UCI-HyperXite/HX8_InverterBoard/Inverter V3.brd

## EAGLE design Inverter V3.brd (2023-04-27)

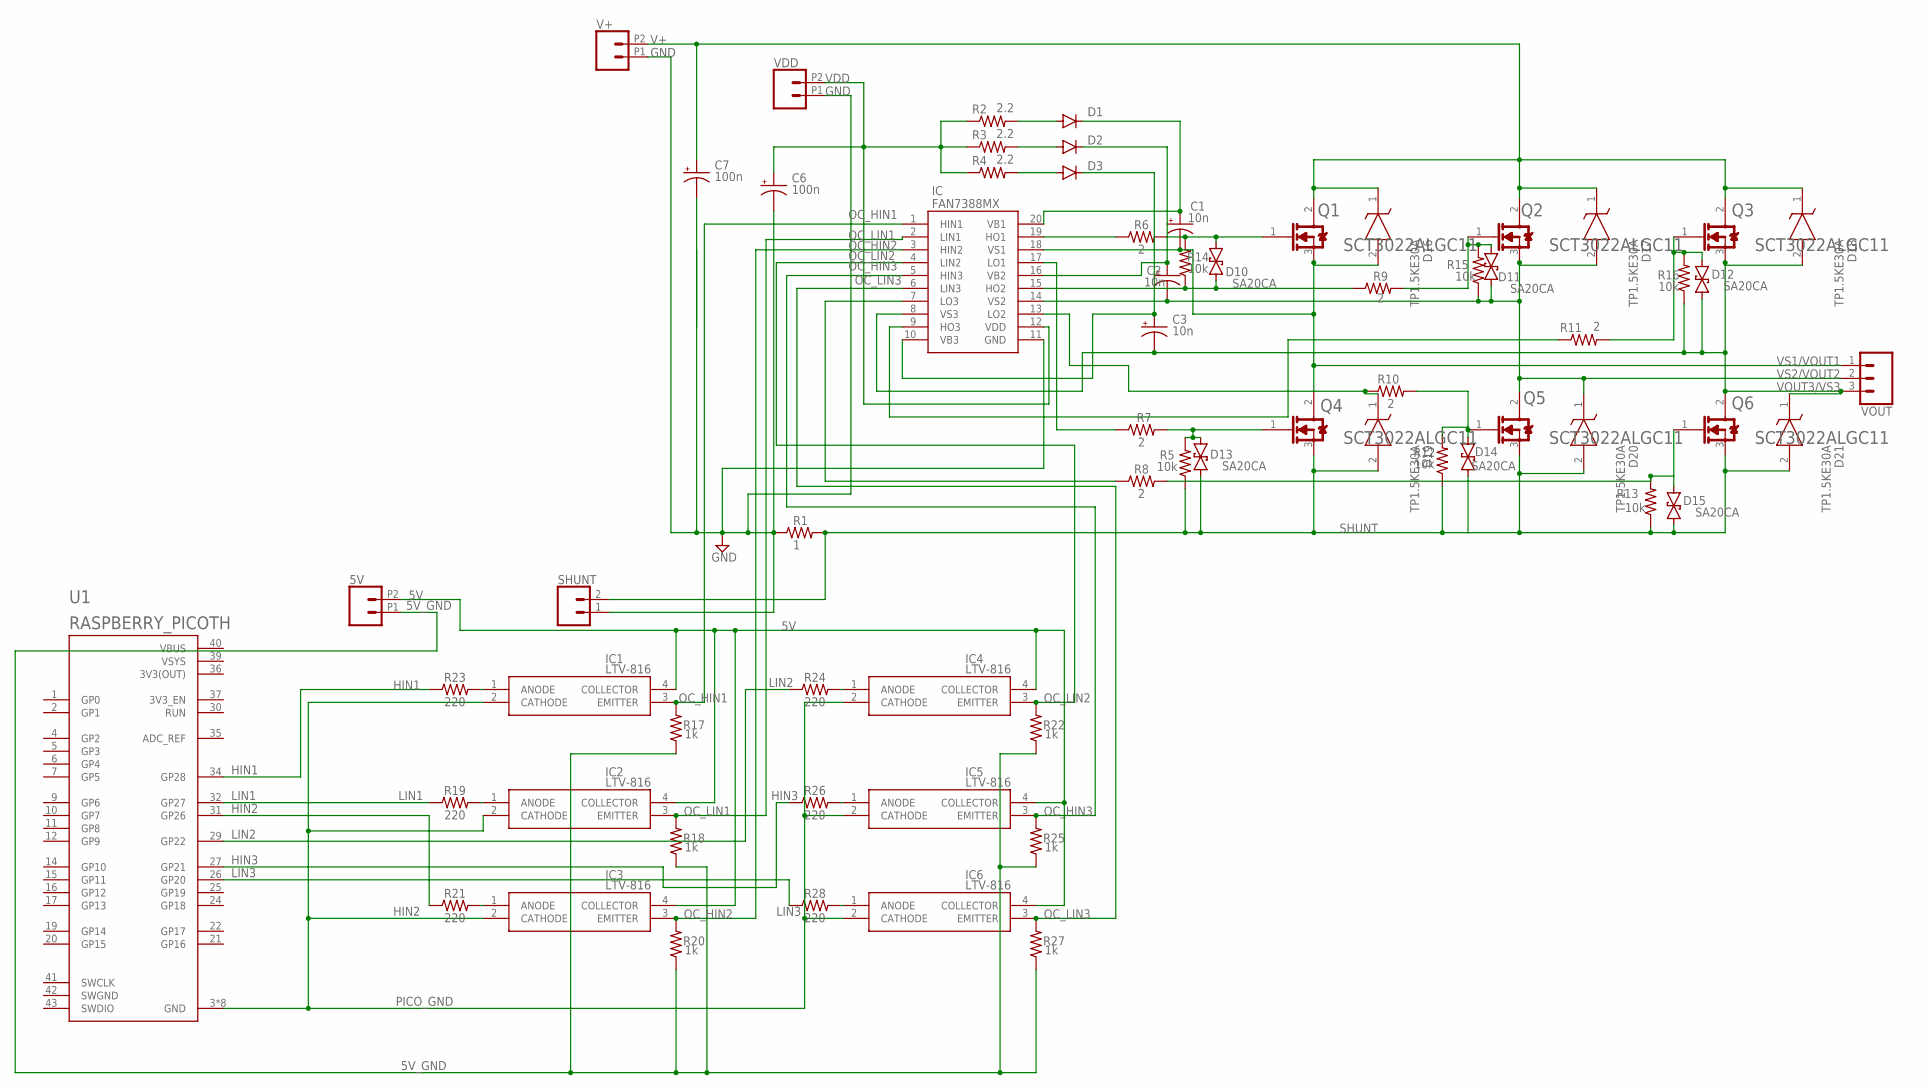
[picture p1: schematic Inverter V3.sch]

Parts:
5V: CONN_022.54MM_SCREWTERM; 1X02_2.54_SCREWTERM
C1, C2, C3: 10n; SMC_Z
C6: 100n; SMC_Z
C7: 100n; E5-5
D1, D2, D3: DIODE-GF1; GF1
D10, D11, D12, D13, D14, D15: SA20CA; CB417-15
D16, D17, D18, D19, D20, D21: TP1.5KE30A; DIOAD2855W107L835D505
IC: FAN7388MX; SOIC127P1032X265-20N
IC1, IC2, IC3, IC4, IC5, IC6: LTV-816; DIP762W60P254L460H450Q4N
Q1, Q2, Q3, Q4, Q5, Q6: ROHM_SCT3022ALGC11ROHM_SCT3022ALGC11_0_0; ROHM_SCT3022ALGC11_0
R1: 1; 0207/10
R2, R3, R4: 2.2; 0603
R5, R12, R13, R14, R15, R16: 10k; 0603
R6, R7, R8, R9, R10, R11: 2; 0603
R17, R18, R20, R22, R25, R27: 1k; 0603
R19, R21, R23, R24, R26, R28: 220; 0603
SHUNT: CONN_02PTH4; 1X02_XTRA_BIG
U1: RASPBERRY_PICOTH; PICO-PKG-TH
V+: CONN_022.54MM_SCREWTERM; 1X02_2.54_SCREWTERM
VDD: CONN_022.54MM_SCREWTERM; 1X02_2.54_SCREWTERM
VOUT: CONN_03SCREW-NS; SCREWTERMINAL-3.5MM-3-NS

Connections:
3V3(OUT): U1.36 (3V3(OUT))
5V: 5V.P2 (2), IC1.4 (COLLECTOR), IC2.4 (COLLECTOR), IC3.4 (COLLECTOR), IC4.4 (COLLECTOR), IC5.4 (COLLECTOR), IC6.4 (COLLECTOR)
5V_GND: 5V.P1 (1), R17.1, R18.1, R20.1, R22.1, R25.1, R27.1
GND: C6.-, C7.-, IC.11 (GND), R1.1, SHUNT.1, V+.P1 (1), VDD.P1 (1)
HIN1: R23.1, U1.34 (GP28)
HIN2: R21.1, U1.31 (GP26)
HIN3: R26.1, U1.27 (GP21)
HO1: IC.19 (HO1), R6.1
HO2: D10.A (1), IC.15 (HO2), R9.1, R14.1
HO3: IC.9 (HO3), R11.1
LIN1: R19.1, U1.32 (GP27)
LIN2: R24.1, U1.29 (GP22)
LIN3: R28.1, U1.26 (GP20)
LO1: IC.17 (LO1), R7.1
LO2: D19.1 (K), IC.13 (LO2), R10.1
LO3: IC.7 (LO3), R8.1
unnamed: IC3.1 (ANODE), R21.2
unnamed: IC2.1 (ANODE), R19.2
unnamed: IC1.1 (ANODE), R23.2
unnamed: IC4.1 (ANODE), R24.2
unnamed: IC5.1 (ANODE), R26.2
unnamed: IC6.1 (ANODE), R28.2
unnamed: D1.A, R2.2
unnamed: D2.A, R3.2
unnamed: D3.A, R4.2
OC_HIN1: IC.1 (HIN1), IC1.3 (EMITTER), R17.2
OC_HIN2: IC.3 (HIN2), IC3.3 (EMITTER), R20.2
OC_HIN3: IC.5 (HIN3), IC5.3 (EMITTER), R25.2
OC_LIN1: IC.2 (LIN1), IC2.3 (EMITTER), R18.2
OC_LIN2: IC.4 (LIN2), IC4.3 (EMITTER), R22.2
OC_LIN3: IC.6 (LIN3), IC6.3 (EMITTER), R27.2
PICO_GND: IC1.2 (CATHODE), IC2.2 (CATHODE), IC3.2 (CATHODE), IC4.2 (CATHODE), IC5.2 (CATHODE), IC6.2 (CATHODE), U1.3 (GND), U1.8 (GND), U1.13 (GND), U1.18 (GND), U1.23 (GND), U1.28 (GND), U1.33 (GND), U1.38 (GND)
SHUNT: D13.A (1), D14.A (1), D15.A (1), D19.2 (A), D20.2 (A), D21.2 (A), Q4.3 (SOURCE), Q5.3 (SOURCE), Q6.3 (SOURCE), R1.2, R5.1, R12.1, R13.1, SHUNT.2
SWGND: U1.42 (SWGND)
V+: C7.+, D16.1 (K), D17.1 (K), D18.1 (K), Q1.2 (DRAIN), Q2.2 (DRAIN), Q3.2 (DRAIN), V+.P2 (2)
VB1: C1.+, D1.C, IC.20 (VB1)
VB2: C2.+, D2.C, IC.16 (VB2)
VB3: C3.+, D3.C, IC.10 (VB3)
VBUS: U1.40 (VBUS)
VDD: C6.+, IC.12 (VDD), R2.1, R3.1, R4.1, VDD.P2 (2)
VGIN1: D10.C (2), Q1.1 (GATE), R6.2, R14.2
VGIN2: D11.C (2), Q2.1 (GATE), R9.2, R15.2
VGIN3: D12.C (2), Q3.1 (GATE), R11.2, R16.2
VGIN4: D13.C (2), Q4.1 (GATE), R5.2, R7.2
VGIN5: D14.C (2), Q5.1 (GATE), R10.2, R12.2
VGIN6: D15.C (2), Q6.1 (GATE), R8.2, R13.2
VOUT3/VS3: C3.-, D12.A (1), D18.2 (A), D21.1 (K), IC.8 (VS3), Q3.3 (SOURCE), Q6.2 (DRAIN), R16.1, VOUT.3
VS1/VOUT1: C1.-, D16.2 (A), IC.18 (VS1), Q1.3 (SOURCE), Q4.2 (DRAIN), VOUT.1
VS2/VOUT2: C2.-, D11.A (1), D17.2 (A), D20.1 (K), IC.14 (VS2), Q2.3 (SOURCE), Q5.2 (DRAIN), R15.1, VOUT.2
VSYS: U1.39 (VSYS)

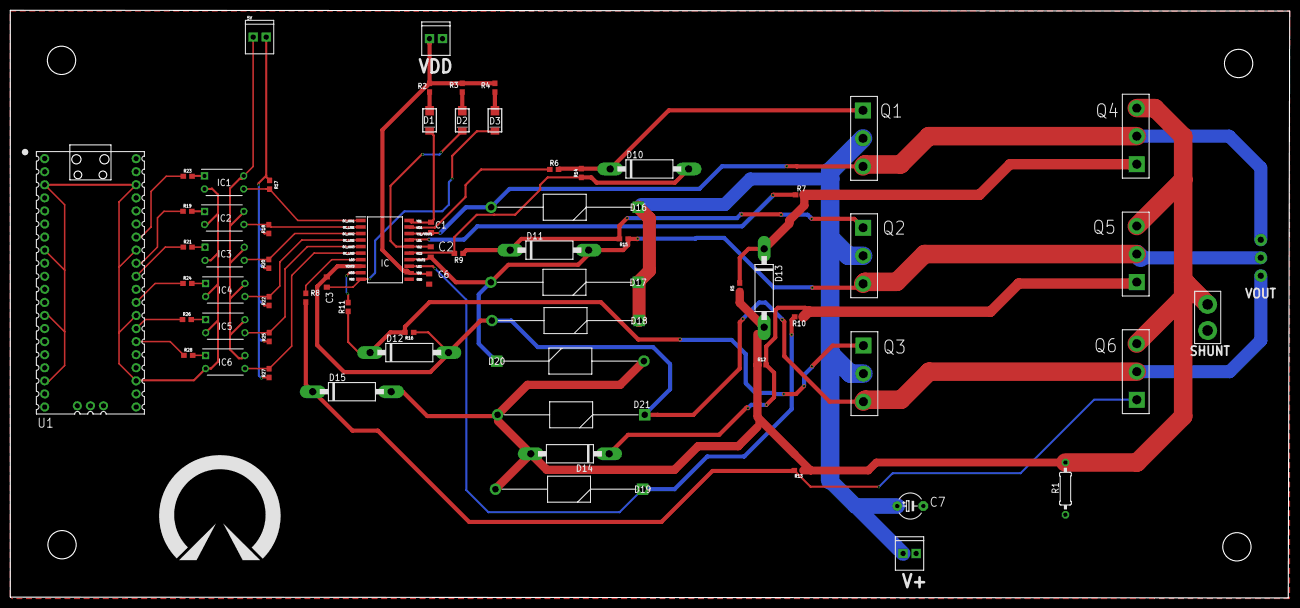
[picture p2: board Inverter V3.brd from above]

Board: 2 copper layers, 248.6 x 114.2 mm, 67 parts (0 on the bottom side), 46 nets.
