UCI-HyperXite/HX8_InverterBoard/Inverter V2_Reroute.brd

## EAGLE design Inverter V2_Reroute.brd (2023-02-24)

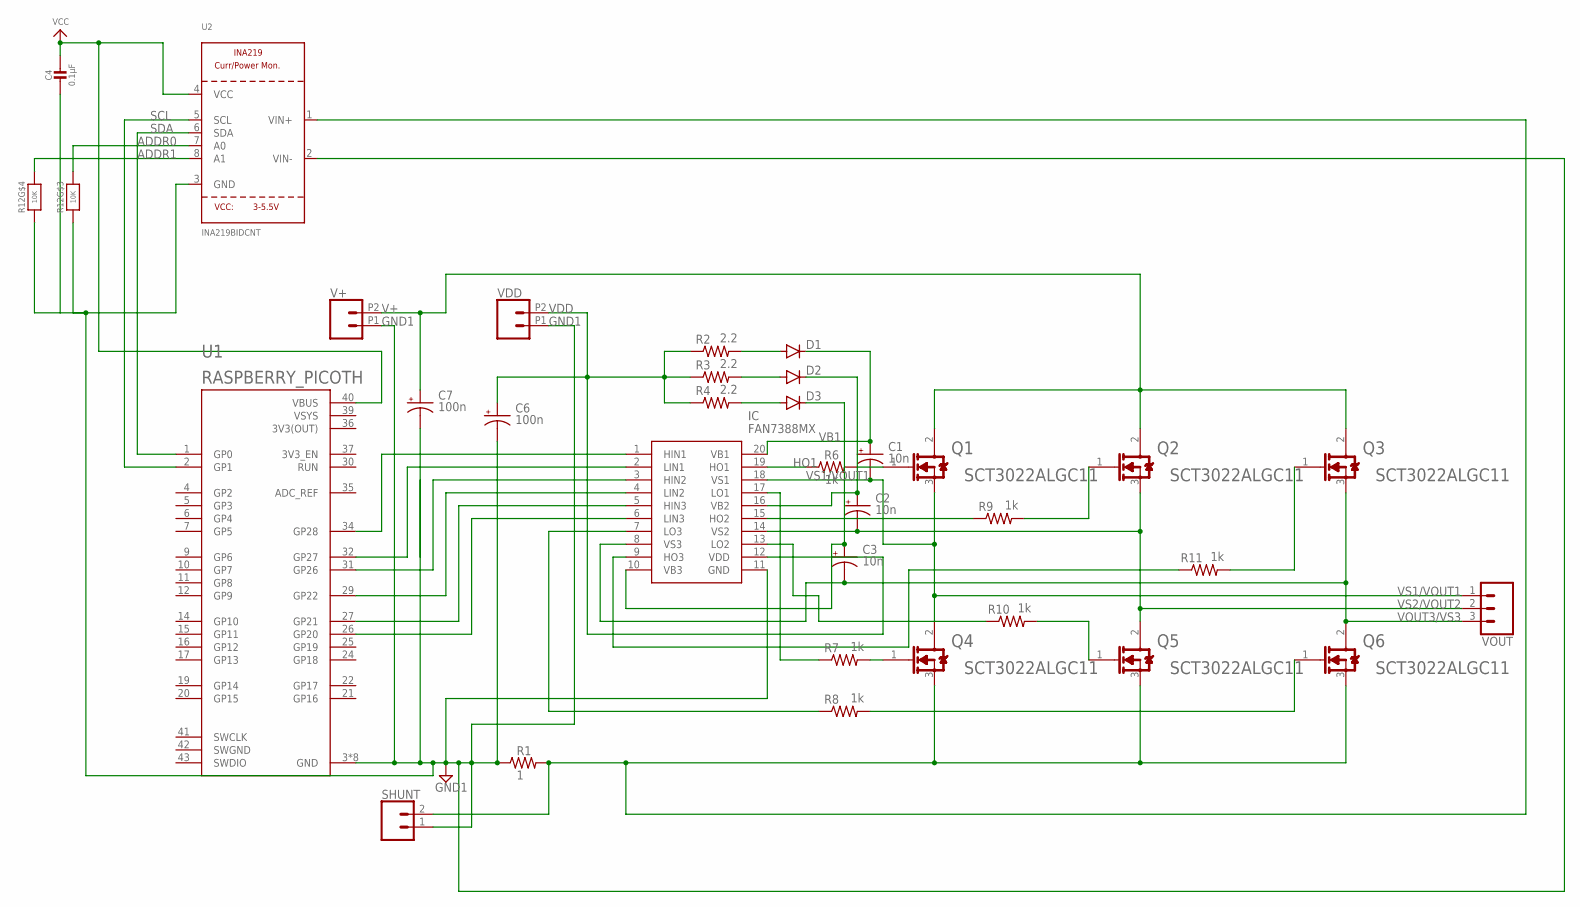
[picture p3: schematic Inverter V2_Reroute.sch]

Parts:
C1, C2, C3: 10n; SMC_Z
C4: 0.1µF; 0603-NO
C6: 100n; SMC_Z
C7: 100n; E5-5
D1, D2, D3: DIODE-GF1; GF1
IC: FAN7388MX; SOIC127P1032X265-20N
Q1, Q2, Q3, Q4, Q5, Q6: ROHM_SCT3022ALGC11ROHM_SCT3022ALGC11_0_0; ROHM_SCT3022ALGC11_0
R1: 1; 0207/10
R2, R3, R4: 2.2; 0603
R6, R7, R8, R9, R10, R11: 1k; 0603
R12: 10K; RESPACK_4X0603
SHUNT: CONN_02PTH4; 1X02_XTRA_BIG
U1: RASPBERRY_PICOTH; PICO-PKG-TH
U2: INA219BIDCNT; SOT23-8
V+: CONN_022.54MM_SCREWTERM; 1X02_2.54_SCREWTERM
VDD: CONN_022.54MM_SCREWTERM; 1X02_2.54_SCREWTERM
VOUT: CONN_03SCREW-NS; SCREWTERMINAL-3.5MM-3-NS

Connections:
3V3(OUT): U1.36 (3V3(OUT))
ADDR0: R12.6 (2), U2.7 (A0)
ADDR1: R12.5 (2), U2.8 (A1)
GND1: C4.2, C6.-, C7.-, IC.11 (GND), R1.1, R12.3 (1), R12.4 (1), SHUNT.1, U1.3 (GND), U1.8 (GND), U1.13 (GND), U1.18 (GND), U1.23 (GND), U1.28 (GND), U1.33 (GND), U1.38 (GND), U2.2 (VIN-), U2.3 (GND), V+.P1 (1), VDD.P1 (1)
HIN1: IC.1 (HIN1), U1.34 (GP28)
HIN3: IC.5 (HIN3), U1.27 (GP21)
HO1: IC.19 (HO1), R6.1
HO2: IC.15 (HO2), R9.1
HO3: IC.9 (HO3), R11.1
LIN1: IC.2 (LIN1), U1.32 (GP27)
LIN2: IC.4 (LIN2), U1.29 (GP22)
LIN3: IC.6 (LIN3), U1.26 (GP20)
LO1: IC.17 (LO1), R7.1
LO2: IC.13 (LO2), R10.1
LO3: IC.7 (LO3), R8.1
unnamed: IC.3 (HIN2), U1.31 (GP26)
unnamed: D1.A, R2.2
unnamed: D2.A, R3.2
unnamed: D3.A, R4.2
SCL: U1.2 (GP1), U2.5 (SCL)
SDA: U1.1 (GP0), U2.6 (SDA)
SHUNT: Q4.3 (SOURCE), Q5.3 (SOURCE), Q6.3 (SOURCE), R1.2, SHUNT.2, U2.1 (VIN+)
SWGND: U1.42 (SWGND)
V+: C7.+, Q1.2 (DRAIN), Q2.2 (DRAIN), Q3.2 (DRAIN), V+.P2 (2)
VB1: C1.+, D1.C, IC.20 (VB1)
VB2: C2.+, D2.C, IC.16 (VB2)
VB3: C3.+, D3.C, IC.10 (VB3)
VCC: C4.1, U1.40 (VBUS), U2.4 (VCC)
VDD: C6.+, IC.12 (VDD), R2.1, R3.1, R4.1, VDD.P2 (2)
VGIN1: Q1.1 (GATE), R6.2
VGIN2: Q2.1 (GATE), R9.2
VGIN3: Q3.1 (GATE), R11.2
VGIN4: Q4.1 (GATE), R7.2
VGIN5: Q5.1 (GATE), R10.2
VGIN6: Q6.1 (GATE), R8.2
VOUT3/VS3: C3.-, IC.8 (VS3), Q3.3 (SOURCE), Q6.2 (DRAIN), VOUT.3
VS1/VOUT1: C1.-, IC.18 (VS1), Q1.3 (SOURCE), Q4.2 (DRAIN), VOUT.1
VS2/VOUT2: C2.-, IC.14 (VS2), Q2.3 (SOURCE), Q5.2 (DRAIN), VOUT.2
VSYS: U1.39 (VSYS)

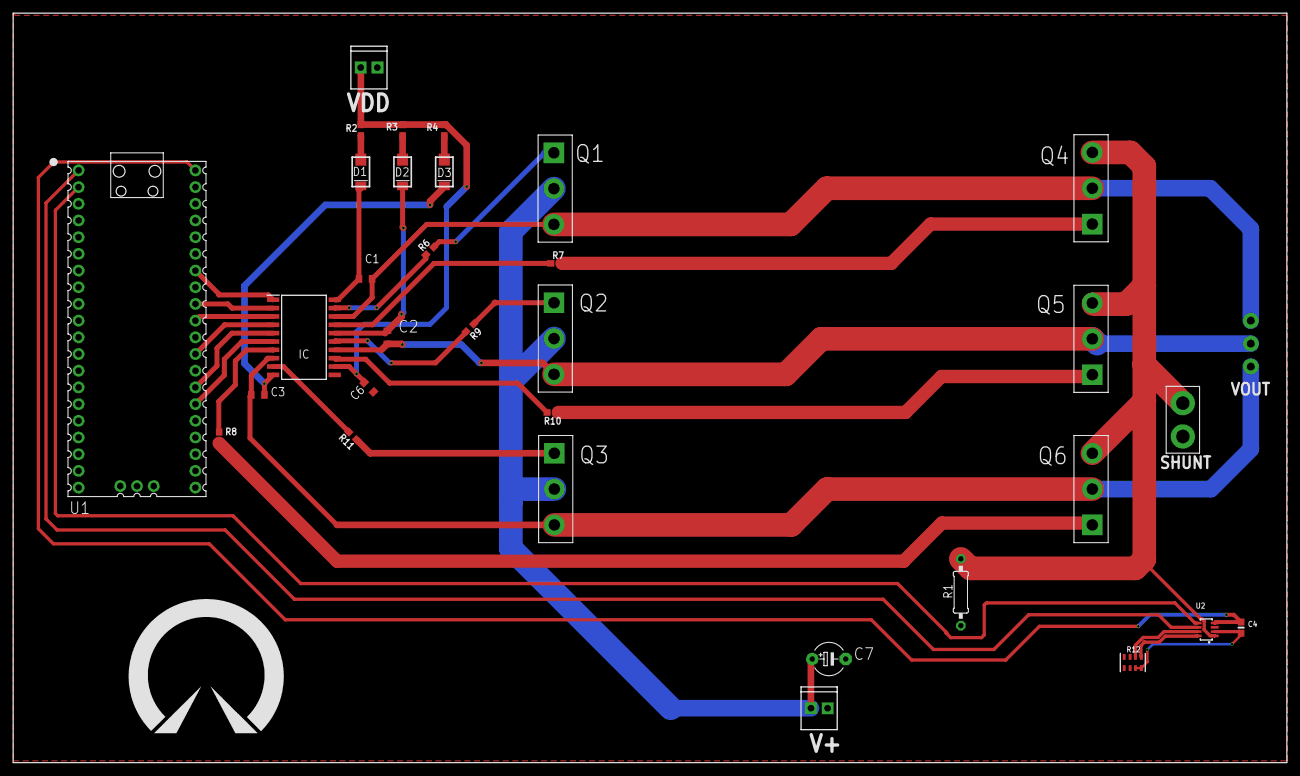
[picture p4: board Inverter V2_Reroute.brd from above]

Board: 2 copper layers, 193.8 x 114.0 mm, 33 parts (0 on the bottom side), 36 nets.
