UCI-HyperXite/HX8_InverterBoard/11_21_22 Inverter.brd

## EAGLE design 11_21_22 Inverter.brd (2022-11-22)

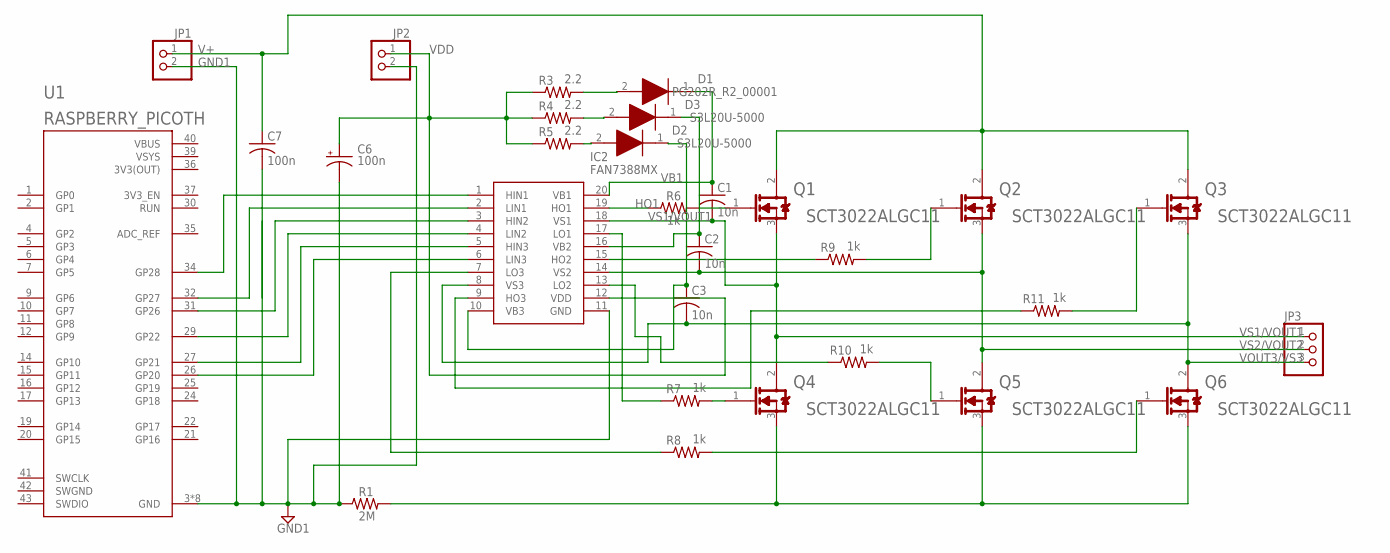
[picture p5: schematic 11_21_22 Inverter.sch]

Parts:
C1, C2, C3: 10n; C025-024X044
C6: 100n; SMC_Z
C7: 100n; C025-024X044
D1: PG202R_R2_00001; DIOAD2460W140L700D440; MANUFACTURER_PART_NUMBER PG202R_R2_00001; MOUSER_PART_NUMBER PG202R_R2_00001
D2, D3: S3L20U-5000; DIOAD2460W140L700D440
IC2: FAN7388MX; SOIC127P1032X265-20N
JP1, JP2: PINHD-1X2; 1X02
JP3: PINHD-1X3; 1X03
Q1, Q2, Q3, Q4, Q5, Q6: ROHM_SCT3022ALGC11ROHM_SCT3022ALGC11_0_0; ROHM_SCT3022ALGC11_0
R1: 2M; 0207/10
R3, R4, R5: 2.2; 0207/10
R6, R7, R8, R9, R10, R11: 1k; 0603
U1: RASPBERRY_PICOTH; PICO-PKG-TH

Connections:
3V3(OUT): U1.36 (3V3(OUT))
COM/GND: Q4.3 (SOURCE), Q5.3 (SOURCE), Q6.3 (SOURCE), R1.2
GND1: C6.-, C7.2, IC2.11 (GND), JP1.2, JP2.2, R1.1, U1.3 (GND), U1.8 (GND), U1.13 (GND), U1.18 (GND), U1.23 (GND), U1.28 (GND), U1.33 (GND), U1.38 (GND)
HO1: IC2.19 (HO1), R6.1
HO2: IC2.15 (HO2), R9.1
LO2: IC2.13 (LO2), R10.1
LO3: IC2.7 (LO3), R8.1
unnamed: IC2.1 (HIN1), U1.34 (GP28)
unnamed: IC2.17 (LO1), R7.1
unnamed: IC2.2 (LIN1), U1.32 (GP27)
unnamed: IC2.3 (HIN2), U1.31 (GP26)
unnamed: IC2.4 (LIN2), U1.29 (GP22)
unnamed: Q1.1 (GATE), R6.2
unnamed: IC2.5 (HIN3), U1.27 (GP21)
unnamed: Q5.1 (GATE), R10.2
unnamed: IC2.6 (LIN3), U1.26 (GP20)
unnamed: Q3.1 (GATE), R11.2
unnamed: Q2.1 (GATE), R9.2
unnamed: IC2.9 (HO3), R11.1
unnamed: Q6.1 (GATE), R8.2
unnamed: Q4.1 (GATE), R7.2
unnamed: D1.2 (A), R3.2
unnamed: D3.2 (A), R4.2
unnamed: D2.2 (A), R5.2
SWGND: U1.42 (SWGND)
V+: C7.1, JP1.1, Q1.2 (DRAIN), Q2.2 (DRAIN), Q3.2 (DRAIN)
VB1: C1.1, D1.1 (K), IC2.20 (VB1)
VB2: C2.1, D3.1 (K), IC2.16 (VB2)
VB3: C3.1, D2.1 (K), IC2.10 (VB3)
VBUS: U1.40 (VBUS)
VDD: C6.+, IC2.12 (VDD), JP2.1, R3.1, R4.1, R5.1
VOUT3/VS3: C3.2, IC2.8 (VS3), JP3.3, Q3.3 (SOURCE), Q6.2 (DRAIN)
VS1/VOUT1: C1.2, IC2.18 (VS1), JP3.1, Q1.3 (SOURCE), Q4.2 (DRAIN)
VS2/VOUT2: C2.2, IC2.14 (VS2), JP3.2, Q2.3 (SOURCE), Q5.2 (DRAIN)
VSYS: U1.39 (VSYS)

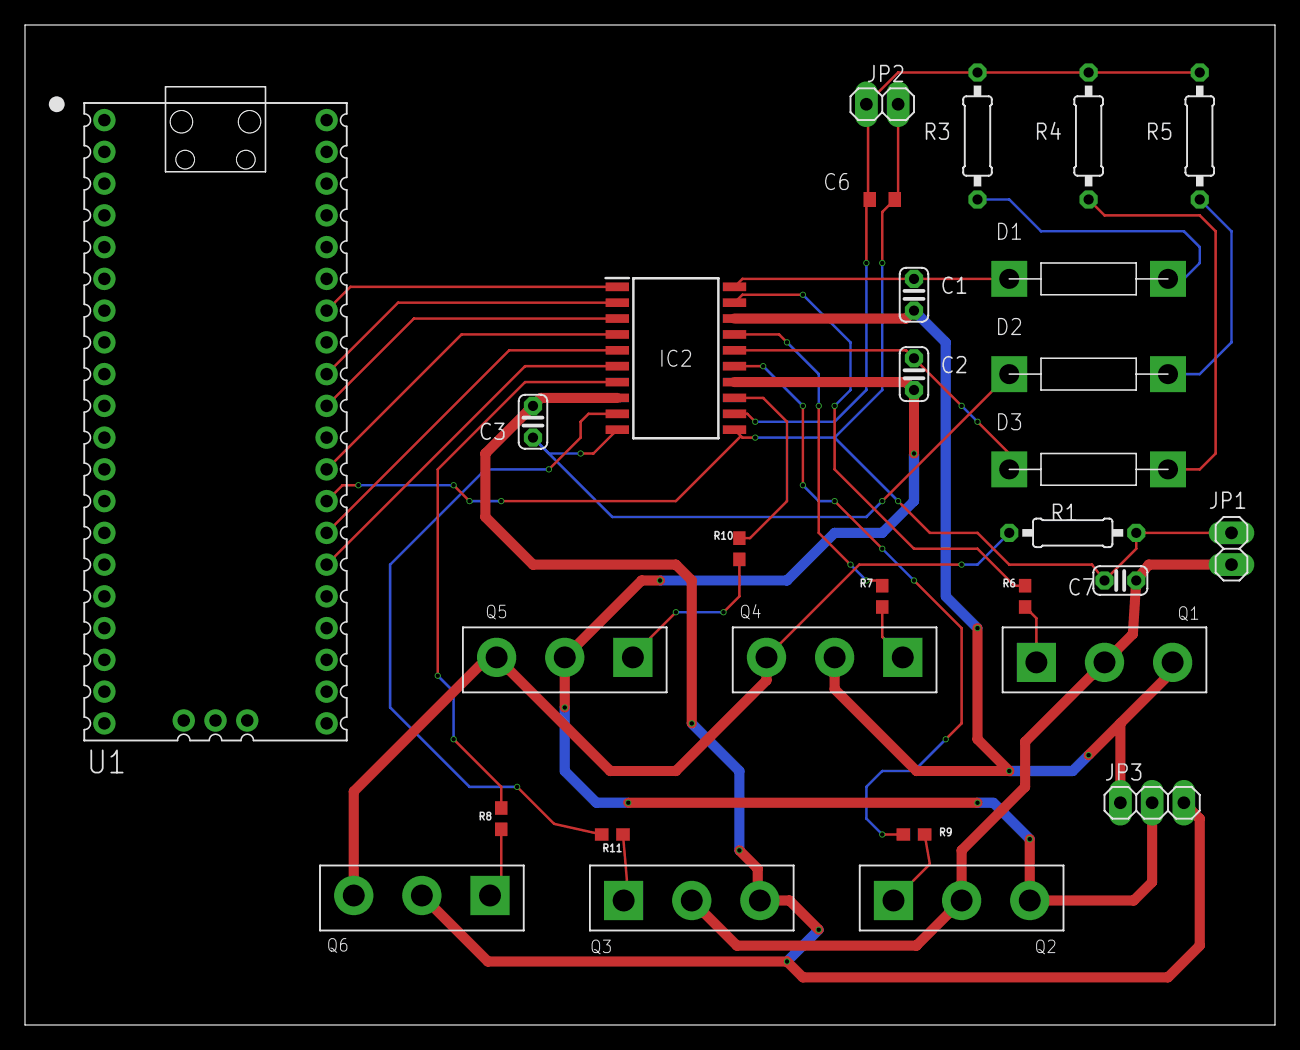
[picture p6: board 11_21_22 Inverter.brd from above]

Board: 2 copper layers, 100.0 x 80.0 mm, 29 parts (0 on the bottom side), 31 nets.
