UCI-HyperXite/HX8_InverterBoard/11_16_22 Inverter PCB.brd

## EAGLE design 11_16_22 Inverter PCB.brd (2022-11-16)

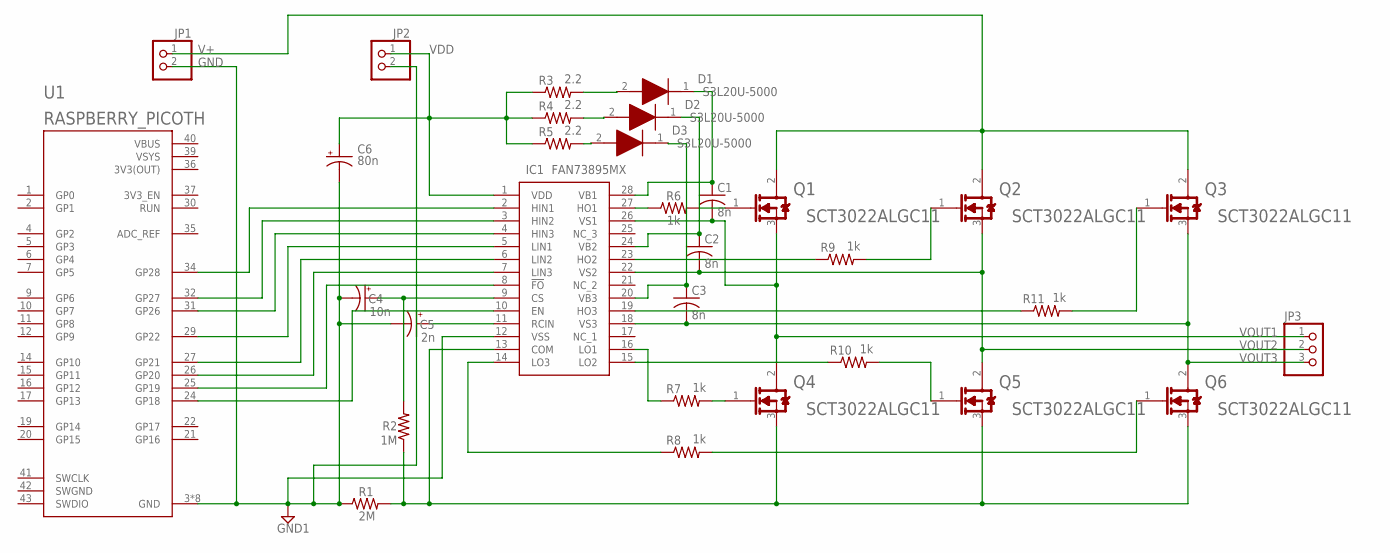
[picture p7: schematic 11_16 Inverter PCB Schematic.sch]

Parts:
C1, C2, C3: 8n; C025-024X044
C4: 10n; SMC_Z
C5: 2n; SMC_Z
C6: 80n; SMC_Z
D1, D2, D3: S3L20U-5000; DIOAD2460W140L700D440
IC1: FAN73895MX; SOIC127P1031X265-28N
JP1, JP2: PINHD-1X2; 1X02
JP3: PINHD-1X3; 1X03
Q1, Q2, Q3, Q4, Q5, Q6: ROHM_SCT3022ALGC11ROHM_SCT3022ALGC11_0_0; ROHM_SCT3022ALGC11_0
R1: 2M; 0207/10
R2: 1M; 0207/10
R3, R4, R5: 2.2; 0207/10
R6, R7, R8, R9, R10, R11: 1k; 0603
U1: RASPBERRY_PICOTH; PICO-PKG-TH

Connections:
3V3(OUT): U1.36 (3V3(OUT))
GND: C4.-, C5.-, C6.-, IC1.12 (VSS), JP1.2, JP2.2, R1.1, U1.3 (GND), U1.8 (GND), U1.13 (GND), U1.18 (GND), U1.23 (GND), U1.28 (GND), U1.33 (GND), U1.38 (GND)
unnamed: IC1.2 (HIN1), U1.34 (GP28)
unnamed: IC1.13 (COM), Q4.3 (SOURCE), Q5.3 (SOURCE), Q6.3 (SOURCE), R1.2, R2.1
unnamed: IC1.19 (HO3), R11.1
unnamed: IC1.27 (HO1), R6.1
unnamed: IC1.8 (!FO), U1.25 (GP19)
unnamed: Q1.1 (GATE), R6.2
unnamed: IC1.16 (LO1), R7.1
unnamed: Q5.1 (GATE), R10.2
unnamed: IC1.14 (LO3), R8.1
unnamed: Q3.1 (GATE), R11.2
unnamed: Q2.1 (GATE), R9.2
unnamed: IC1.10 (EN), U1.24 (GP18)
unnamed: IC1.23 (HO2), R9.1
unnamed: Q6.1 (GATE), R8.2
unnamed: IC1.15 (LO2), R10.1
unnamed: Q4.1 (GATE), R7.2
unnamed: C1.1, D1.1 (K), IC1.28 (VB1)
unnamed: C2.1, D2.1 (K), IC1.24 (VB2)
unnamed: C3.1, D3.1 (K), IC1.20 (VB3)
unnamed: IC1.3 (HIN2), U1.32 (GP27)
unnamed: C5.+, IC1.11 (RCIN)
unnamed: IC1.4 (HIN3), U1.31 (GP26)
unnamed: IC1.5 (LIN1), U1.29 (GP22)
unnamed: IC1.6 (LIN2), U1.27 (GP21)
unnamed: IC1.7 (LIN3), U1.26 (GP20)
unnamed: D1.2 (A), R3.2
unnamed: C4.+, IC1.9 (CS), R2.2
unnamed: D2.2 (A), R4.2
unnamed: D3.2 (A), R5.2
SWGND: U1.42 (SWGND)
V+: JP1.1, Q1.2 (DRAIN), Q2.2 (DRAIN), Q3.2 (DRAIN)
VBUS: U1.40 (VBUS)
VDD: C6.+, IC1.1 (VDD), JP2.1, R3.1, R4.1, R5.1
VOUT1: C1.2, IC1.26 (VS1), JP3.1, Q1.3 (SOURCE), Q4.2 (DRAIN)
VOUT2: C2.2, IC1.22 (VS2), JP3.2, Q2.3 (SOURCE), Q5.2 (DRAIN)
VOUT3: C3.2, IC1.18 (VS3), JP3.3, Q3.3 (SOURCE), Q6.2 (DRAIN)
VSYS: U1.39 (VSYS)

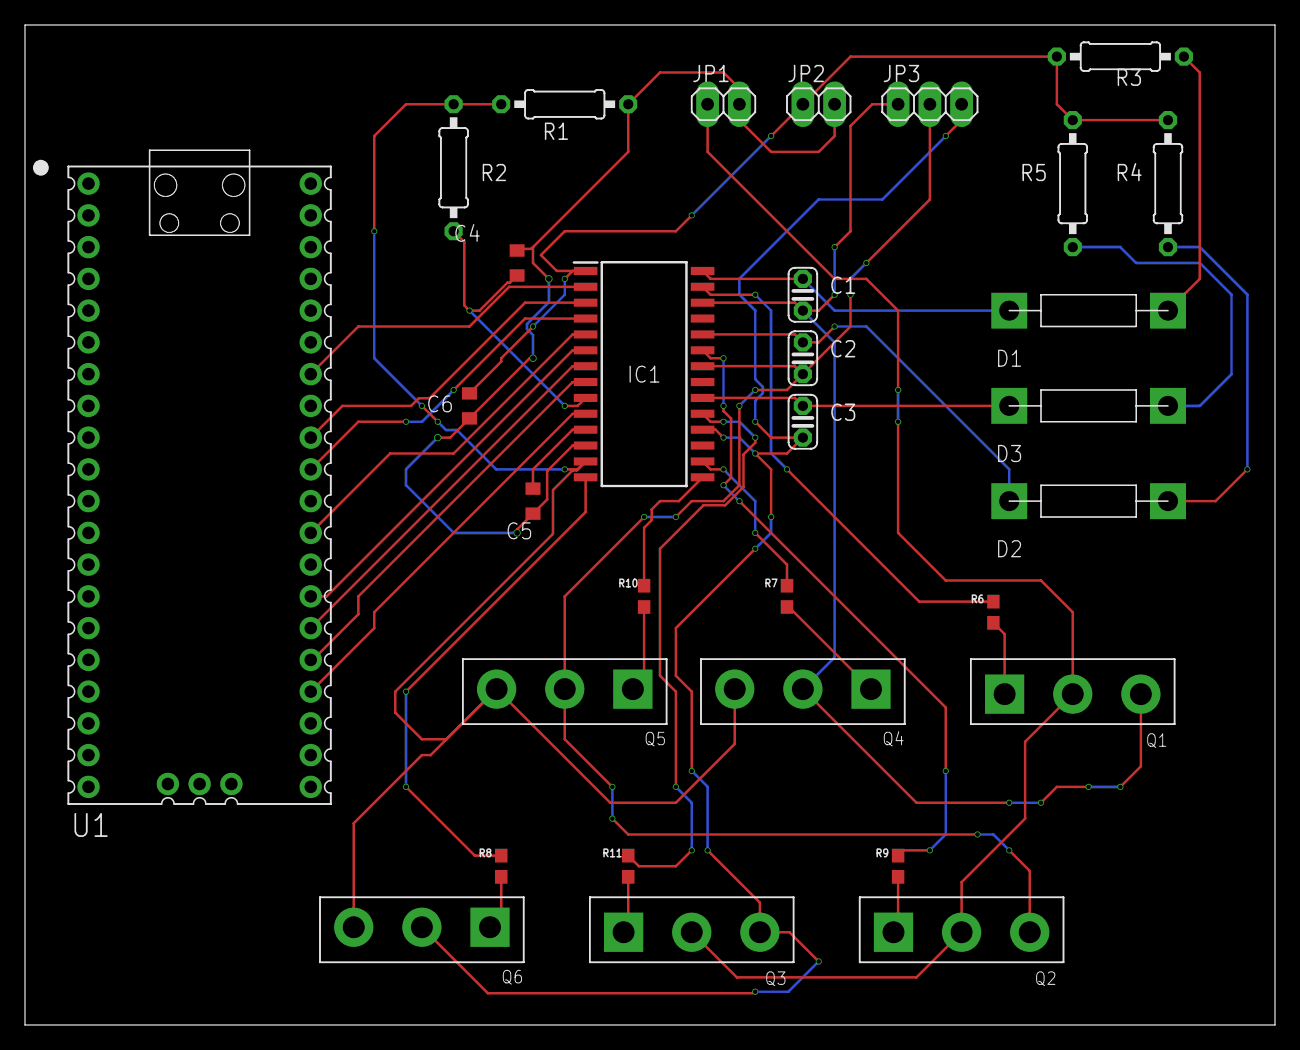
[picture p8: board 11_16_22 Inverter PCB.brd from above]

Board: 2 copper layers, 100.0 x 80.0 mm, 31 parts (0 on the bottom side), 35 nets.
