UCI-HyperXite/HX8_InverterBoard/(commit log)

2022-11-16 Add first version of PCB for inverter
    [11_16_22 Inverter PCB.brd]
2022-11-17 Add schematic and gerber files
    [11_16 Inverter PCB Schematic.sch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]
2022-11-17 Rename gerber files folder
    [11_16_22 Inverter PCB.GBL, 11_16_22 Inverter PCB.GBO, 11_16_22 Inverter PCB.GBP, 11_16_22 Inverter PCB.GBS, 11_16_22 Inverter PCB.GKO, 11_16_22 Inverter PCB.GTL, 11_16_22 Inverter PCB.GTO, 11_16_22 Inverter PCB.GTP]
2022-11-21 Fixing schematic and PCB, adding gerber files
    [11_16_22 Inverter.GBL, 11_16_22 Inverter.GBO, 11_16_22 Inverter.GBP, 11_16_22 Inverter.GBS, 11_16_22 Inverter.GKO, 11_16_22 Inverter.GTL, 11_16_22 Inverter.GTO, 11_16_22 Inverter.GTP]
2022-11-22 Updated inverter board and schematic with new IC
    [11_21_22 Inverter.brd, 11_21_22 Inverter.sch]
2023-02-09 Inverter V2 initial files
    [Inverter V2.brd, Inverter V2.sch]
2023-02-14 Routing Inverter V2
    [Inverter V2.brd, Inverter V2.sch]
2023-02-15 Revision to routed V2 inverter
    [Inverter V2.brd, Inverter V2.sch]
2023-02-15 Adjusted trace width + silkscreen
    [Inverter V2.brd]
2023-02-24 Rerouted inverter to minimize analog signal for INA219
    [Inverter V2_Reroute.brd, Inverter V2_Reroute.sch]
2023-04-14 Inverter V3
    [Inverter V3.brd, Inverter V3.sch]
2023-04-27 Swapped flyback diodes and added silkscreen for IC pins
    [Inverter V3.brd, Inverter V3.sch]
